uutzinger/LTC2473/hardware/LTC2473CDR1_bom.xlsx

Item # | *Designator | *Qty | Manufacturer | *Mfg Part # | Description / Value | *Package/Footprint | Type | Your Instructions / Notes
1 | C1, C2, C3, C4, C5, C7, C8, C9, C10, C11 | 10 | Murata Electronics | GRM188R72A104KA35J | CAP 0.1uF 10V | 603 | SMD | LCSC 0.1UF-0603-10V
2 | R1, R2, R3, R4, R5, R6, R7, R8 | 8 | YAGEO | RC0603FR-0710KL | RES 10k 0603 1/10W 1% | 603 | SMD | LCSC 10KOHM-0603-1/10W-1%
3 | C6, C12 | 2 | Murata Electronics | GRM188R61A106KE69D | CAP 10uF 10V | 603 | SMD | LCSC 10UF-0603-10V
4 | R16 | 1 | YAGEO | RE0603FRE071KL | RES 1k 0603 1/10W 1% | 603 | SMD | LCSC 1KOHM-0603-1/10W-1%
5 | J1 | 1 | TE Connectivity AMP Connectors | 282834-4 | TERM BLK 4P SIDE ENT 2.54MM PCB | 2.54mm | thru-hole | 4 Position Wire to Board Terminal Block Horizontal with Board 0.100" (2.54mm) Through Hole 10.3mm height
7 | D1 | 1 | Lite-On | LTST-C190KGKT | GREEN LED SMD 2V | 603 | SMD | LCSC Green LED
8 | U1, U2 | 2 | Analog Devices | LTC2473IMS#PBF | IC ADC 16BIT SIGMA-DELTA 12MSOP | MSOP-12 | SMD | 16 Bit Analog to Digital Converter 1 Input 1 Sigma-Delta 12-MSOP
9 | J3, J4 | 2 | JST | SM04B-SRSS-TB | JST SH CONN HEADER SMD R/A 4POS 1MM | JST04_1MM_RA | SMD | QWIIC connector
10 | JP1,JP2,SJ4 | 2 | unpopulated | N.A. | not populated | N.A. | N.A. | Do not populate
