uutzinger/LTC2473/hardware/LTC2473CDR1.brd

## EAGLE design hardware/LTC2473CDR1.brd (2023-11-05)

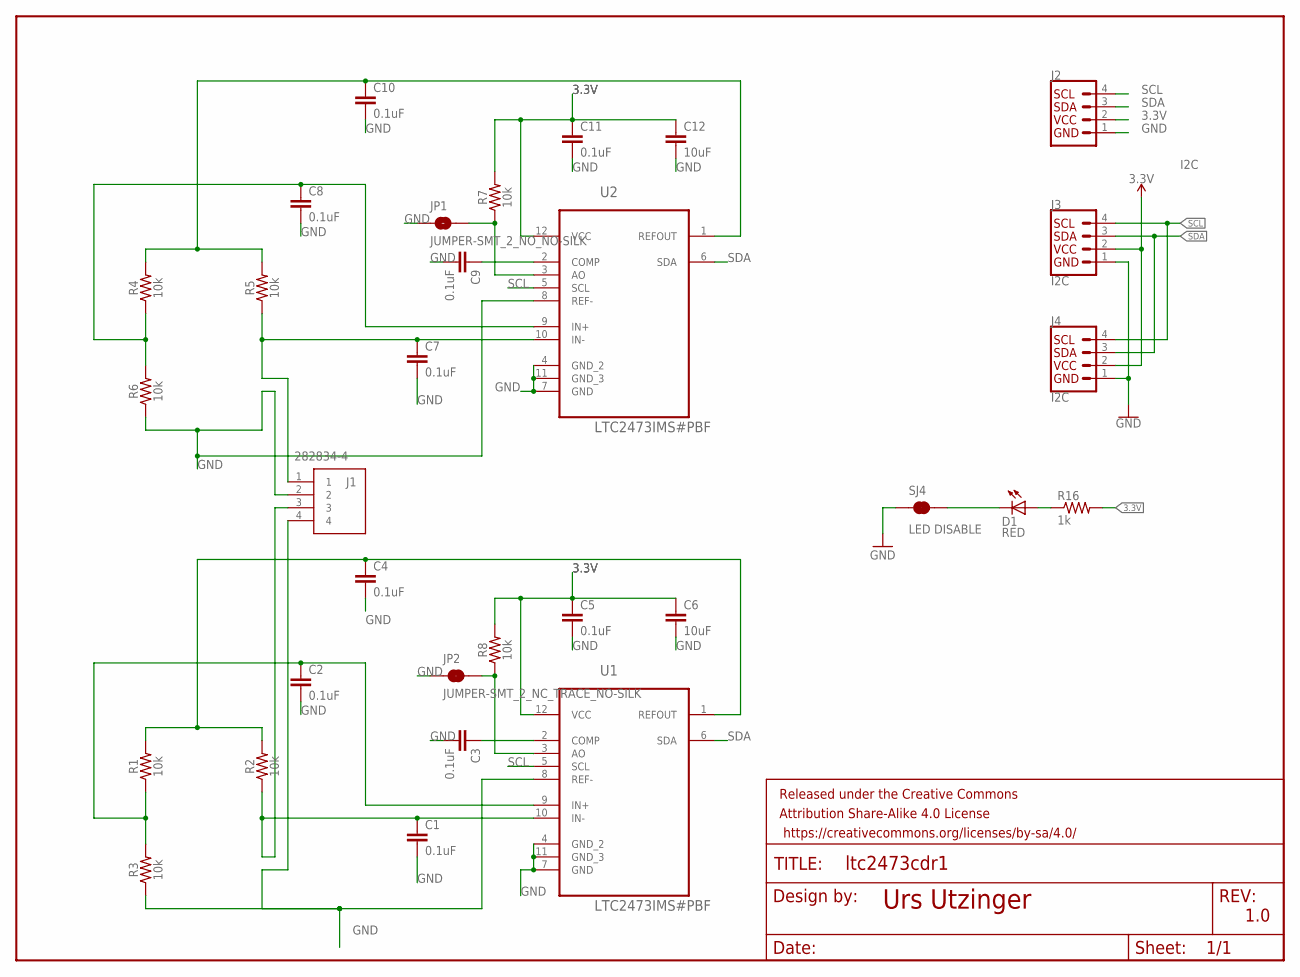
[picture p6: schematic LTC2473CDR1.sch]

Parts:
C1, C2, C3, C4, C5, C7, C8, C9, C10, C11: 0.1uF; 0603
C6, C12: 10uF; 0603
D1: RED; LED-0603
FRAME1: FRAME-LETTERNO_PACKAGE; DUMMY
J1: 282834-4; 2828344
J2: I2C; 1X04
J3, J4: I2C; JST04_1MM_RA
JP1: JUMPER-SMT_2_NO_NO-SILK; SMT-JUMPER_2_NO_NO-SILK
JP2: JUMPER-SMT_2_NC_TRACE_NO-SILK; SMT-JUMPER_2_NC_TRACE_NO-SILK
R1, R2, R3, R4, R5, R6, R7, R8: 10k; 0603
R16: 1k; 0603
SJ4: LED DISABLE; SMT-JUMPER_2_NC_TRACE_NO-SILK
U1, U2: LTC2473IMS#PBF; SOP65P490X110-12N

Connections:
3.3V: C5.1, C6.1, C11.1, C12.1, J2.2, J3.2, J4.2, R7.2, R8.2, R16.2, U1.12 (VCC), U2.12 (VCC)
GND: C1.2, C2.2, C3.2, C4.2, C5.2, C6.2, C7.2, C8.2, C9.2, C10.2, C11.2, C12.2, J1.2, J1.4, J2.1, J3.1, J4.1, JP1.1, JP2.1, R3.1, R6.1, SJ4.1, U1.4 (GND_2), U1.7 (GND), U1.8 (REF-), U1.11 (GND_3), U2.4 (GND_2), U2.7 (GND), U2.8 (REF-), U2.11 (GND_3)
unnamed: C3.1, U1.2 (COMP)
unnamed: C2.1, R1.1, R3.2, U1.9 (IN+)
unnamed: C8.1, R4.1, R6.2, U2.9 (IN+)
unnamed: C4.1, R1.2, R2.2, U1.1 (REFOUT)
unnamed: JP1.2, R7.1, U2.3 (AO)
unnamed: D1.A, R16.1
unnamed: C7.1, J1.1, R5.1, U2.10 (IN-)
unnamed: C10.1, R4.2, R5.2, U2.1 (REFOUT)
unnamed: D1.C, SJ4.2
unnamed: C9.1, U2.2 (COMP)
unnamed: C1.1, J1.3, R2.1, U1.10 (IN-)
unnamed: JP2.2, R8.1, U1.3 (AO)
SCL: J2.4, J3.4, J4.4, U1.5 (SCL), U2.5 (SCL)
SDA: J2.3, J3.3, J4.3, U1.6 (SDA), U2.6 (SDA)

Notes on the sheet:
Urs Utzinger
1.0

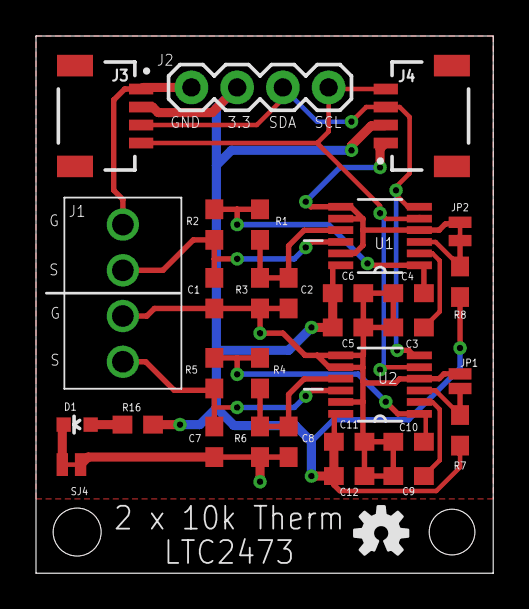
[picture p7: board LTC2473CDR1.brd from above]

Board: 2 copper layers, 25.4 x 29.8 mm, 33 parts (0 on the bottom side), 16 nets.

Other parts of the board:
U$1: OSHW-LOGO-S
